francoismenez/openhand_rits_01/README.md

# openhand_rits_01
An open soruce tool-less assembled robotic hand driven by gear trains: No. 01; Three fingers; Four actuators;
