francoismenez/openhand_rits_01/3finger_front.jpg

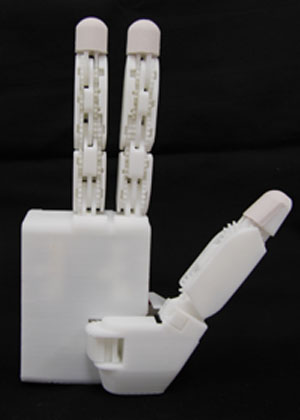
3finger_front.jpg
