francoismenez/openhand_rits_01/PartsList-PramoHand-3FNC.pdf

| Parts | number | Gear | number
IndexFinger | Index-FingerPalmLink Index-Link1 Index-Link1cover Index-Link2 Index-Link2cover Index-Link3 or rubber Index-Motorbase | 1 1 1 1 1 1 1 | φ12.5mm φ15mm φ20mm Φ20mm-FixedLink φ25mm MotorGear | 4 1 2 1 2 1
MiddleFinger | Middle-FingerPalmLink Middle-Link1 Middle-Link1cover Middle-Link2 Middle-Link2cover Middle-Link3 or rubber Middle-Motorbase | 1 1 1 1 1 1 1 | φ12.5mm φ15mm φ20mm Φ20mm-FixedLink φ25mm MotorGear | 4 1 2 1 2 1
ThumbFinger | Thumb-CMLink Thumb-FingerCMLink Thumb-Link1 Thumb-Link1cover Thumb-Link2 or rubber Thumb-Motorbase | 1 1 1 1 1 1 | φ12.5mm φ20mm φ25mm ThumbMotorGear | 2 2 1 1
Palm | Palm PalmCover | 1 1 | MotorGear | 1
