francoismenez/openhand_rits_01/STLfiles/Gear/hole+0.25mm/Φ12.5mm.stl

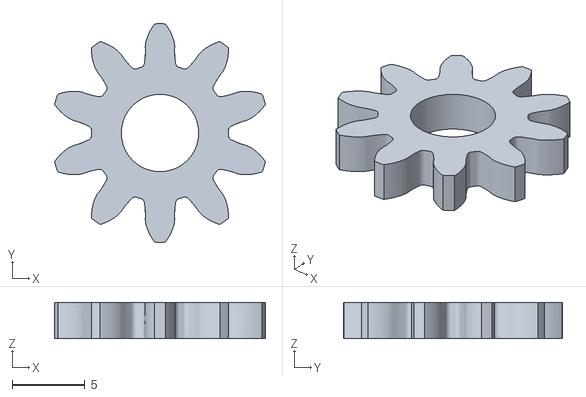
[picture p2: CAD file, 2020-11-05]
STLfiles/Gear/hole+0.25mm/Φ12.5mm.stl
14.5 x 15.0 x 2.50
