francoismenez/openhand_rits_01/STLfiles/Gear/hole-0.10mm/Φ20mm-FixedLink.stl

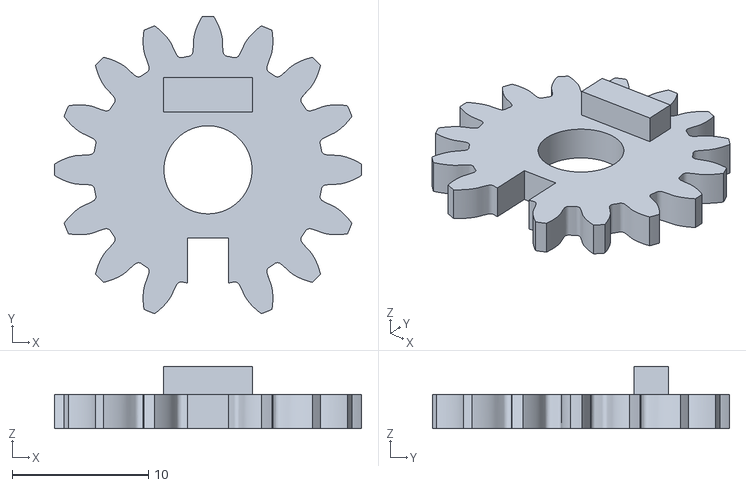
[picture p3: CAD file, 2020-11-05]
STLfiles/Gear/hole-0.10mm/Φ20mm-FixedLink.stl
22.5 x 21.8 x 4.55
