francoismenez/openhand_rits_01/STLfiles/Gear/Φ20mm.stl

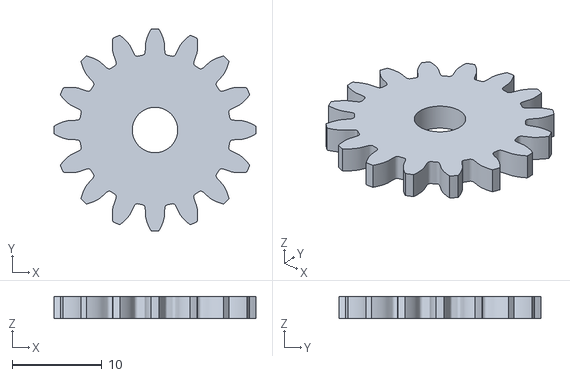
[picture p4: CAD file, 2020-11-05]
STLfiles/Gear/Φ20mm.stl
22.5 x 22.5 x 2.50
