francoismenez/openhand_rits_01/STLfiles/IndexFinger/Index-FingerPalmLink.stl

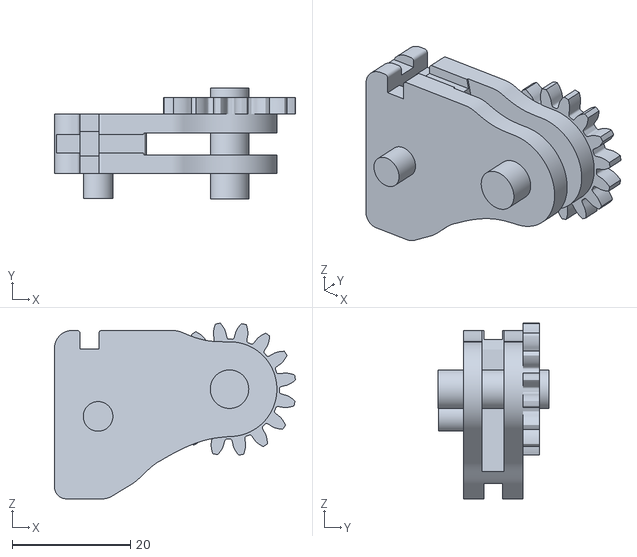
[picture p5: CAD file, 2020-11-05]
STLfiles/IndexFinger/Index-FingerPalmLink.stl
40.7 x 18.8 x 29.7
