francoismenez/openhand_rits_01/STLfiles/MiddleFinger/Middle-Link1.stl

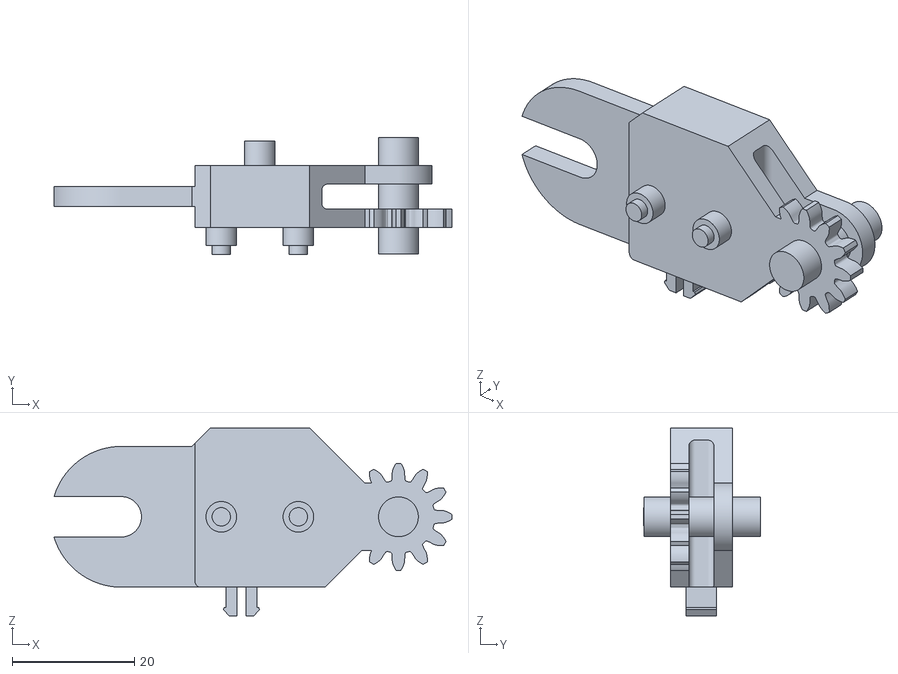
[picture p6: CAD file, 2020-11-05]
STLfiles/MiddleFinger/Middle-Link1.stl
65.0 x 19.1 x 30.7
