francoismenez/openhand_rits_01/STLfiles/Palm/PalmCover.stl

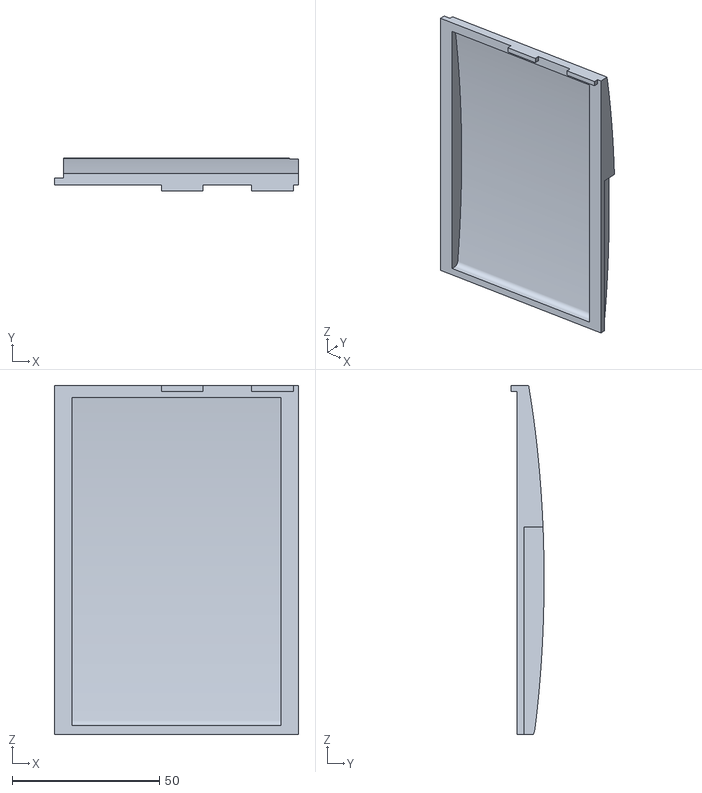
[picture p7: CAD file, 2020-11-05]
STLfiles/Palm/PalmCover.stl
82.9 x 11.3 x 118.5
