francoismenez/openhand_rits_01/STLfiles/ThumbFinger/Thumb-Link2-rubber.stl

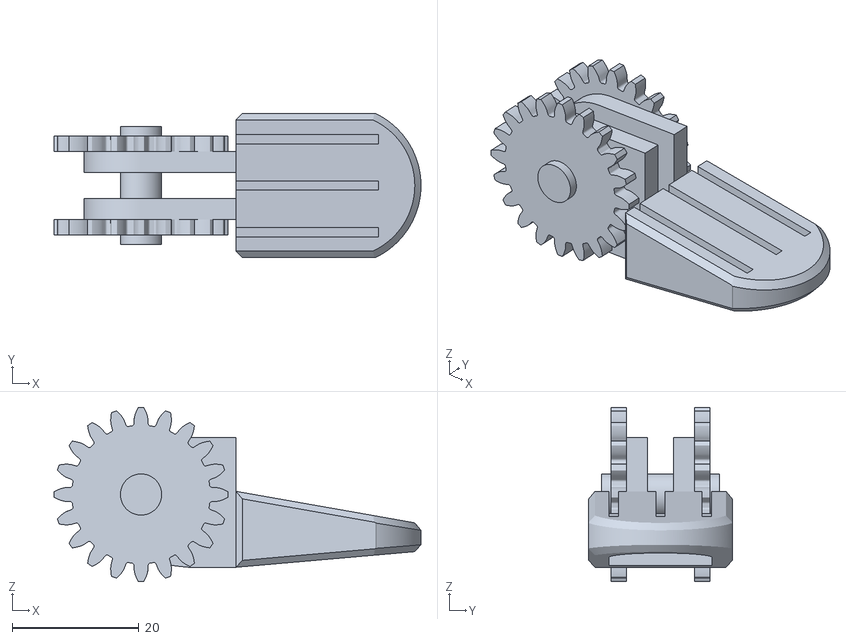
[picture p8: CAD file, 2020-11-05]
STLfiles/ThumbFinger/Thumb-Link2-rubber.stl
58.0 x 22.7 x 27.5
