francoismenez/openhand_rits_01/STLfiles/IndexFinger/Index-Motorbase.stl

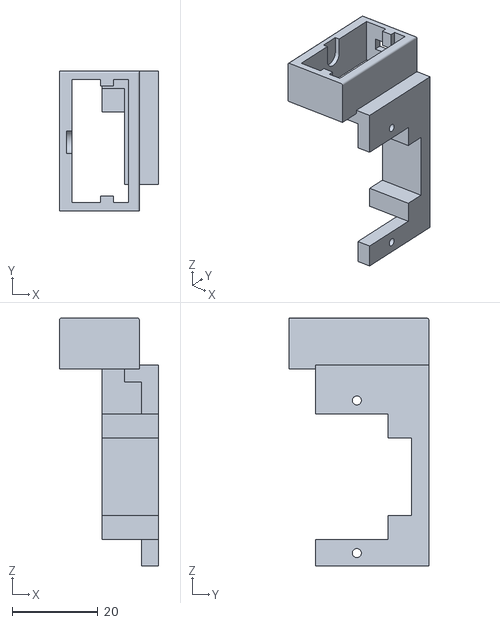
[picture p9: CAD file, 2020-11-05]
STLfiles/IndexFinger/Index-Motorbase.stl
23.2 x 32.6 x 57.9
