francoismenez/openhand_rits_01/STLfiles/ThumbFinger/Thumb-Motorbase.stl

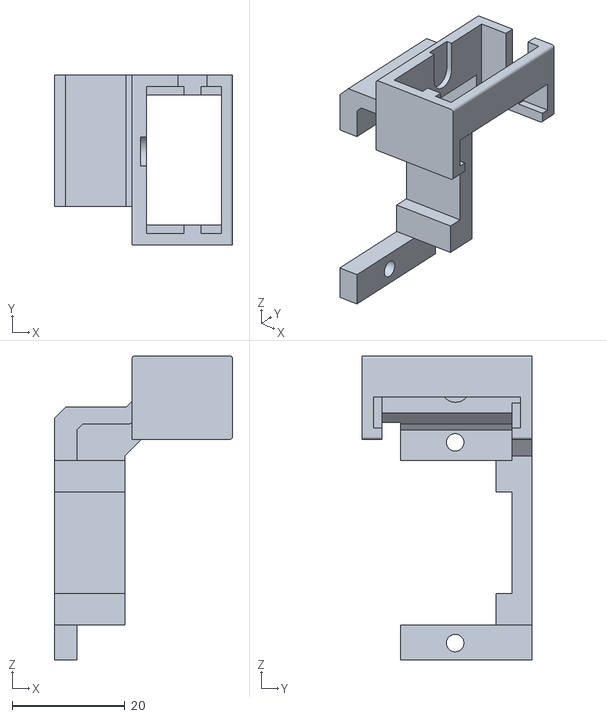
[picture p10: CAD file, 2020-11-05]
STLfiles/ThumbFinger/Thumb-Motorbase.stl
31.7 x 30.1 x 53.9
