francoismenez/openhand_rits_01/STLfiles/Gear/hole+0.25mm/Φ15mm.stl

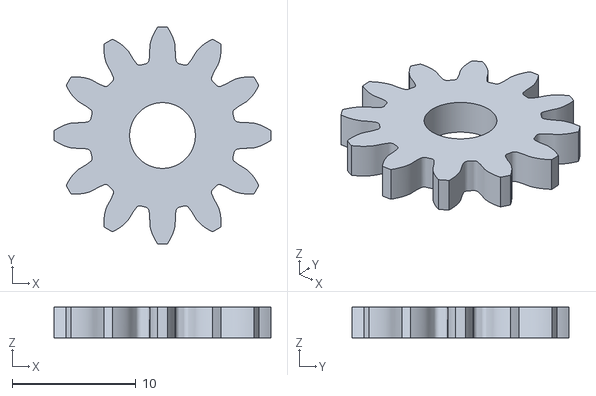
[picture p11: CAD file, 2020-11-05]
STLfiles/Gear/hole+0.25mm/Φ15mm.stl
17.5 x 17.5 x 2.50
