francoismenez/openhand_rits_01/STLfiles/IndexFinger/Index-Link2cover.stl

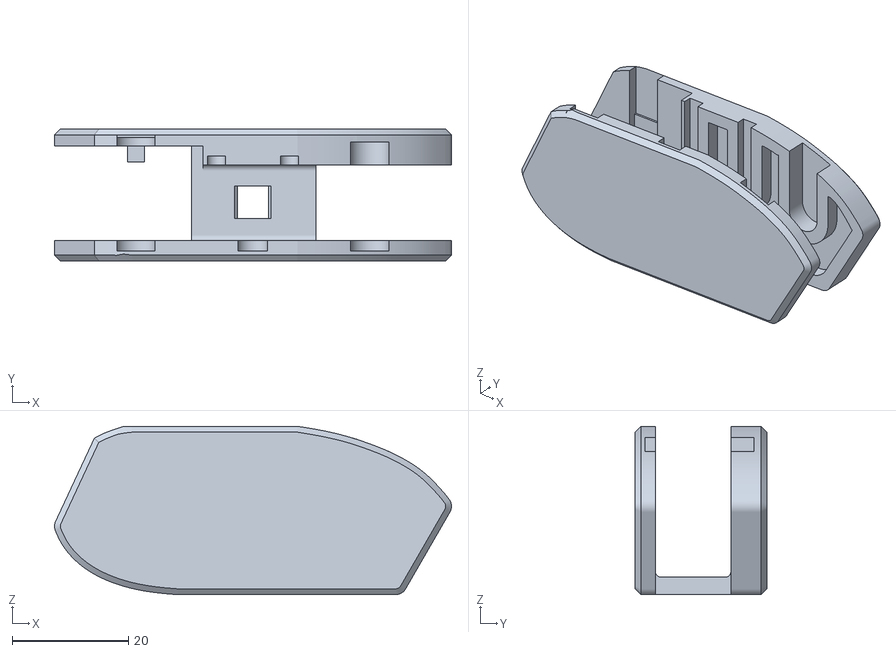
[picture p12: CAD file, 2020-11-05]
STLfiles/IndexFinger/Index-Link2cover.stl
68.4 x 22.7 x 29.0
