francoismenez/openhand_rits_01/STLfiles/MiddleFinger/Middle-Link2.stl

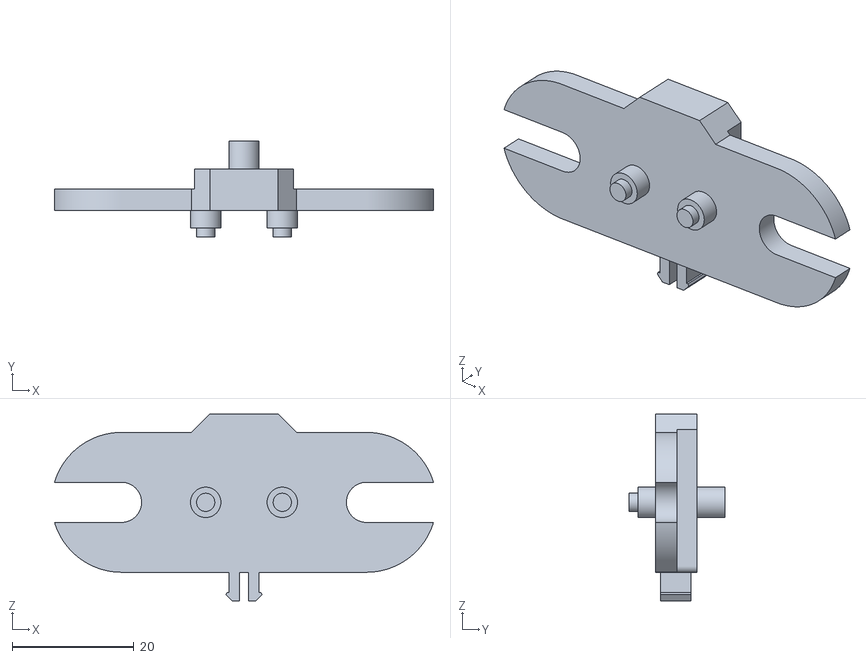
[picture p13: CAD file, 2020-11-05]
STLfiles/MiddleFinger/Middle-Link2.stl
62.3 x 15.8 x 30.7
