francoismenez/openhand_rits_01/STLfiles/ThumbFinger/Thumb-Link1cover.stl

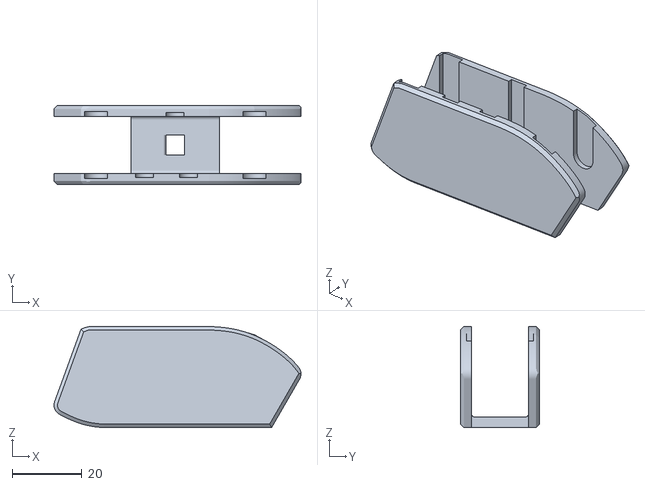
[picture p14: CAD file, 2020-11-05]
STLfiles/ThumbFinger/Thumb-Link1cover.stl
70.8 x 22.7 x 29.0
