francoismenez/openhand_rits_01/STLfiles/Gear/hole+0.25mm/Φ25mm.stl

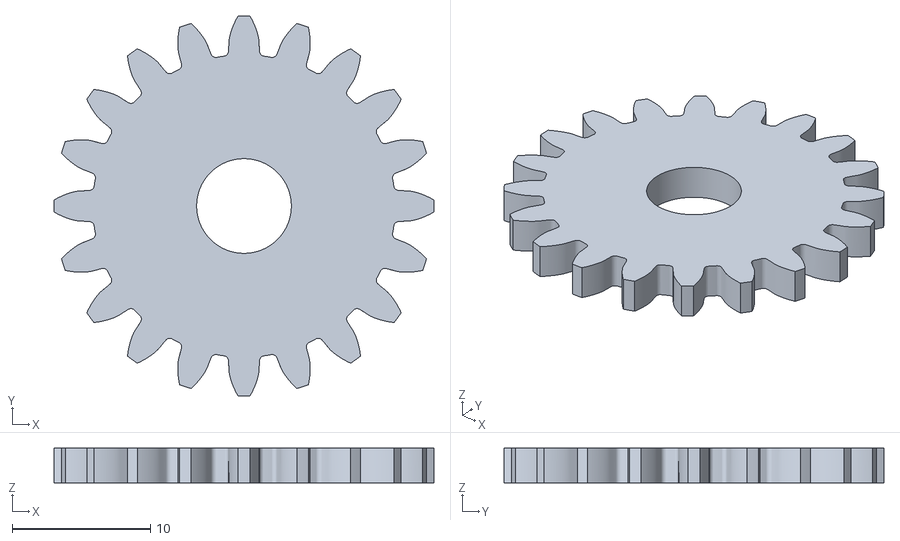
[picture p15: CAD file, 2020-11-05]
STLfiles/Gear/hole+0.25mm/Φ25mm.stl
27.5 x 27.5 x 2.50
