francoismenez/openhand_rits_01/STLfiles/Gear/MotorGear.stl

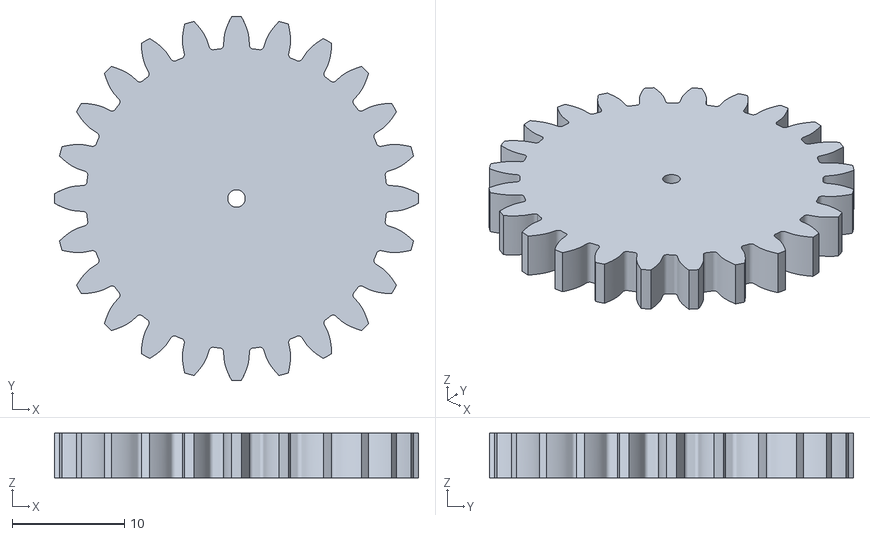
[picture p16: CAD file, 2020-11-05]
STLfiles/Gear/MotorGear.stl
32.5 x 32.5 x 4.00
