francoismenez/openhand_rits_01/STLfiles/ThumbFinger/Thumb-Link1.stl

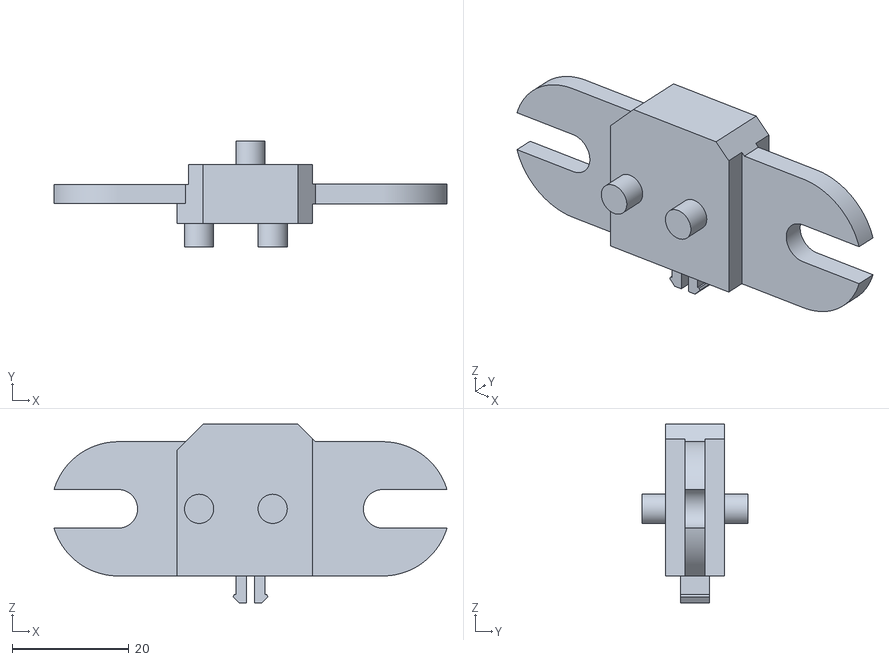
[picture p17: CAD file, 2020-11-05]
STLfiles/ThumbFinger/Thumb-Link1.stl
67.3 x 18.1 x 30.6
