francoismenez/openhand_rits_01/STLfiles/MiddleFinger/Middle-Link1cover.stl

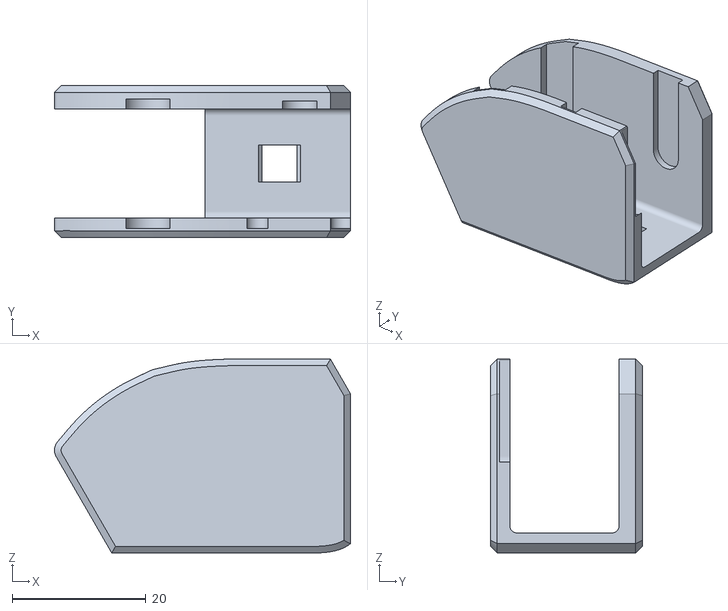
[picture p18: CAD file, 2020-11-05]
STLfiles/MiddleFinger/Middle-Link1cover.stl
44.3 x 22.7 x 29.0
