francoismenez/openhand_rits_01/STLfiles/ThumbFinger/Thumb-FingerCMLink.stl

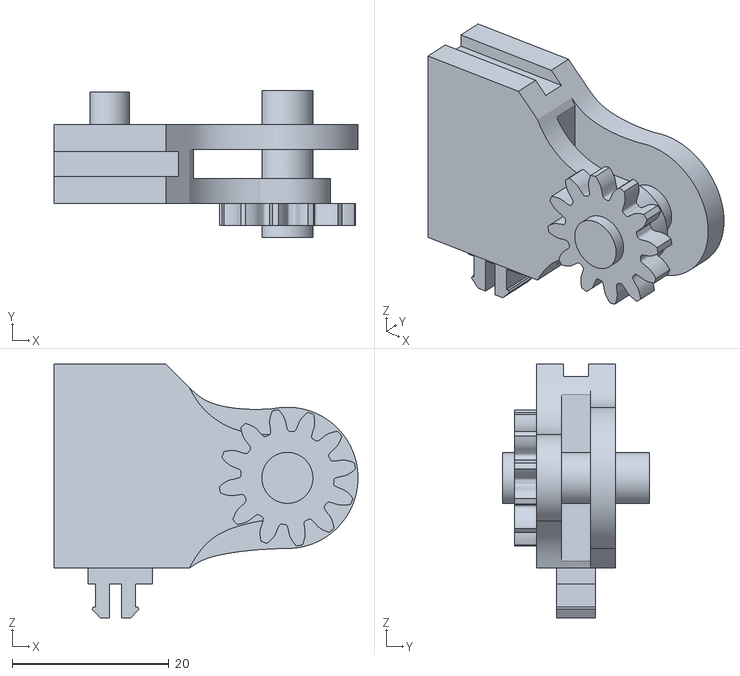
[picture p19: CAD file, 2020-11-05]
STLfiles/ThumbFinger/Thumb-FingerCMLink.stl
38.7 x 18.7 x 32.4
