francoismenez/openhand_rits_01/STLfiles/Gear/ThumbMotorGear.stl

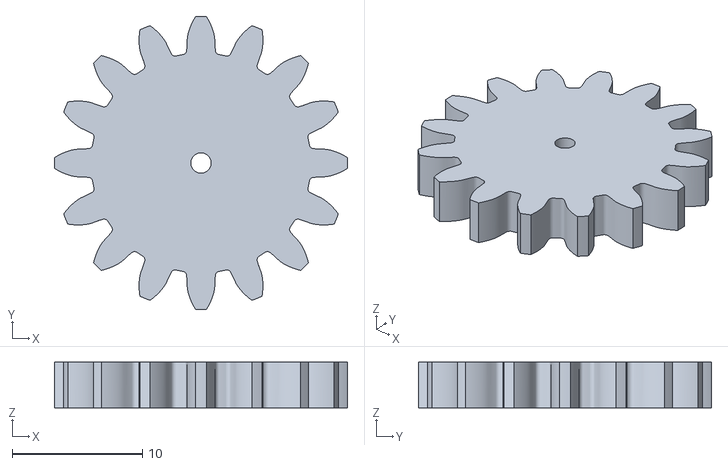
[picture p20: CAD file, 2020-11-05]
STLfiles/Gear/ThumbMotorGear.stl
22.5 x 22.5 x 3.50
