francoismenez/openhand_rits_01/STLfiles/MiddleFinger/Middle-Link3-rubber.stl

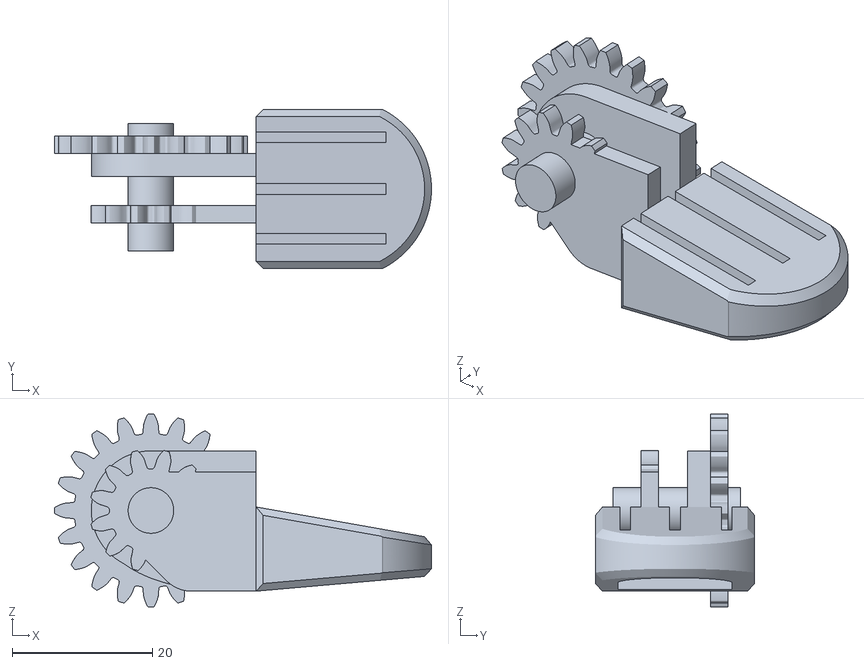
[picture p21: CAD file, 2020-11-05]
STLfiles/MiddleFinger/Middle-Link3-rubber.stl
53.8 x 22.7 x 27.5
