francoismenez/openhand_rits_01/STLfiles/MiddleFinger/Middle-Motorbase.stl

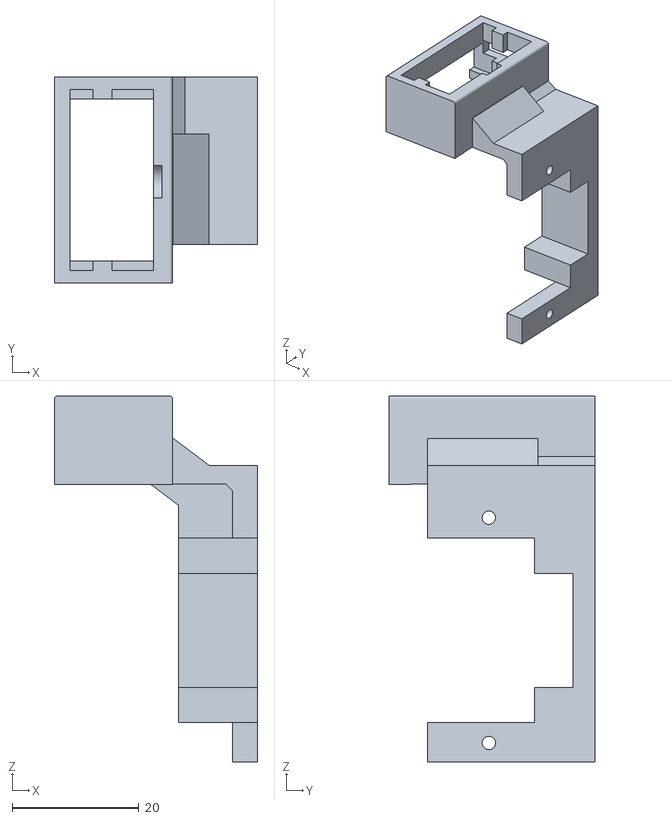
[picture p22: CAD file, 2020-11-05]
STLfiles/MiddleFinger/Middle-Motorbase.stl
32.2 x 32.6 x 57.9
