francoismenez/openhand_rits_01/(list of files, cad)

Other CAD files:
STLfiles/Gear/hole+0.25mm/Φ20mm.stl
STLfiles/Gear/hole-0.10mm/Φ20mm.stl
STLfiles/Gear/Φ20mm-FixedLink.stl
STLfiles/MiddleFinger/Middle-FingerPalmLink.stl
STLfiles/Gear/hole-0.10mm/Φ12.5mm.stl
STLfiles/Gear/Φ15mm.stl
STLfiles/Gear/hole-0.10mm/Φ15mm.stl
STLfiles/IndexFinger/Index-Link1.stl
STLfiles/MiddleFinger/Middle-Link2cover.stl
STLfiles/Gear/hole+0.25mm/Φ20mm-FixedLink.stl
STLfiles/Gear/hole-0.10mm/Φ25mm.stl
STLfiles/Gear/Φ25mm.stl
STLfiles/IndexFinger/Index-Link2.stl
STLfiles/IndexFinger/Index-Link1cover.stl
STLfiles/Gear/Φ12.5mm.stl
STLfiles/IndexFinger/Index-Link3-rubber.stl
